topquark22/Thermo55/(threads)

Thread 3 (2023-11-27):

Feature request: Coarse and fine threshold

topquark22, 2023-11-27:
- Implement a 2nd POT for fine threshold adjustment
- Coarse POT has range -100 - 300 degrees
- Fine POT has range +/- 40 degrees added to coarse POT resding

Problem: There are no analog pins remaining in the parallel_interface configuration, so this will only be possible in the I2C configuration.

topquark22, 2023-11-28:
Implemented in 1-RELEASE, 1P-RELEASE

Closed 2023-11-28.

Thread 4 (2024-01-20):

always-on display doesn't work as described

topquark22, 2024-01-20:
Found in: Branch V3

Expected behaviour:
Always-on display switch is actively-read and takes effect during the loop. It keeps the display on if engaged. If not engaged, the display is deactivated after the timeout period .

Actual behaviour:
Always-on display takes effect after the display is activated. It doesn't ever turn off the display even if the switch is disengaged.

topquark22, 2024-02-14:
Fixed in 4.0.1

Closed 2024-02-14.
