topquark22/Thermo55/(commit log)

2023-11-07 CS = pin 9
2023-11-07 Open circuit test working
2023-11-07 circuit open without thermocouple
2023-11-08 add support for status LED
2023-11-08 prototype is working
2023-11-09 add support for inverted output
    [thermo55.ino]
2023-11-17 change theromocouple to separate CS pin
2023-11-19 change CS to pin A5
2023-11-20 change CS pin to 8
2023-11-20 track max/min temperature since reset
    [thermo55.ino]
2023-11-21 I2C implementation
2023-11-21 change DS4 to pin A5
2023-11-21 I2C success!
2023-11-24 hold while max/min button pressed
2023-11-24 I2C ADDR
2023-11-24 fix max/min hold logic
    [thermo55.ino]
2023-11-24 new button functionality
2023-11-24 backlight timer
2023-11-25 print alarm status to serial
2023-11-25 fix max/min sampling bug
    [thermo55.ino]
2023-11-26 preserve max/min display while button pressed
2023-11-26 fix clock pin name
2023-11-26 only reset MAX/MIN on backlight expiry
    [thermo55.ino]
2023-11-26 fix display off bug
    [thermo55.ino]
2023-11-26 fix max/min display bug
    [thermo55.ino]
2023-11-27 how to reset MAX/MIN values
    [thermo55.ino]
2023-11-28 extend display after reset max/min
    [thermo55.ino]
2023-11-28 fix max/min display timing
    [thermo55.ino]
2023-11-28 revert delta for activating display
    [thermo55.ino]
2023-11-30 intermediate stage
2023-12-02 fix radio setup (xmit mode)
    [thermo55.ino, thermo55_radio.cpp, thermo55_radio.h]
2023-12-02 fix MAX31855 SPI clock pin
    [thermo55.ino]
2023-12-02 fix loop timing in receiver
    [thermo55.h, thermo55.ino, thermo55_radio.cpp]
2023-12-02 2 separate SPI buses
2023-12-02 power, channel jumpers
2023-12-02 handle undefined temperature
2023-12-03 change xmit/recv pin from D6 to A1
2023-12-03 change always-on to pin D6
2023-12-03 pin assignments
2023-12-03 pin assignment
2023-12-03 change always-on pin to D6
2023-12-05 reverse sense of enableRadio pin
    [thermo55.ino, thermo55_radio.cpp, thermo55_radio.h]
2024-02-12 implement auxiliary control output on pin D3
2024-02-12 change role of pin A3 to Fahrenheit display selection
2024-02-12 update major release because of pin A3 wiring change
2024-02-13 fix MAX/MIN display for Fahrenheit setting
    [thermo55.ino]
2024-02-13 fix max/min display in case of no data
    [thermo55.ino]
2024-02-14 refactor name of active low pin
2024-02-14 fix max/min display when always-on display is enabled
    [thermo55.ino]
2024-02-14 fix for ticket #4
    [thermo55.ino]
2024-02-14 fix for always-on display
    [thermo55.ino]
2024-02-14 refactor name of active low button pin
2024-02-23 reset auxiliary output on long button press
    [thermo55.ino]
2024-03-23 use program memory for pin numbers
2025-07-05 standalone mode wiring
2025-07-05 MAX31855 wiring table
2025-07-05 MAX31855 wiring chart fixed
2025-07-07 fix always on display wrt display countdown timer
    [thermo55.ino]
2025-08-28 power note
2025-08-28 power requirement
2025-08-28 pin A3 doc
2025-08-29 fix wiritng table for LCD
2025-08-29 detect pin A6, A7 support
2025-09-06 Correction to pin descriptions
2025-09-06 make alert direction switchable within the loop
2025-09-20 mention the relevant pin
2025-09-20 explain how to #define the radio channel, device ID
2025-10-10 connecting the thermocouple breakout board
2025-11-18 blink LED on radio fault
2025-11-18 fix blink duration on thermocouple error
    [thermo55.ino]
2025-12-04 Update README with D5 button connection instructions
    Clarified D5 connection details for button and debouncing.
2025-12-04 Remove V5 important notes from main README
    Removed important notes for V5 regarding pin assignments and features. To be moved to separate release notes.
2025-12-04 Add important release notes for V5
    Updated pin assignments and features for V5 and higher versions.
2025-12-31 Revise pin connection details in README
    Updated pin connection table and notes for clarity.
2025-12-31 Clarify INPUT_PULLUP pin usage in README
    Removed redundant information about INPUT_PULLUP pins.
2026-01-14 Fix typo in README for A0 pin description
